xdylanm/usb-c-psu/images/AP630205_typical_app.png

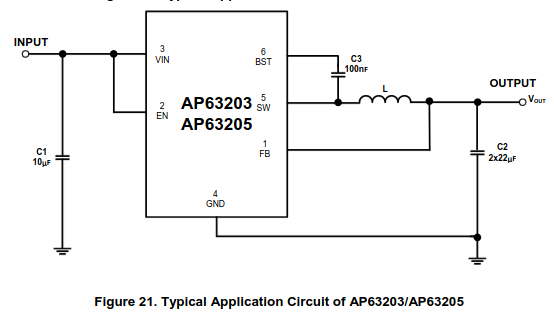
images/AP630205_typical_app.png
