xdylanm/usb-c-psu/images/block_diagram.png

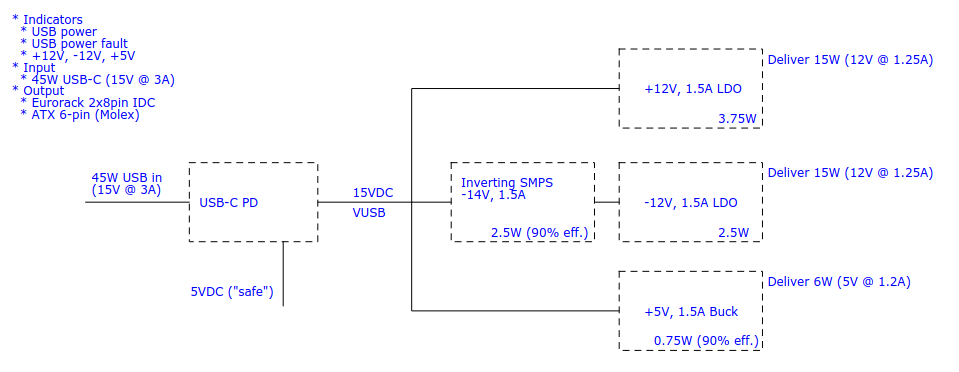
images/block_diagram.png
