xdylanm/usb-c-psu/images/current_paths_inverting_topo.png

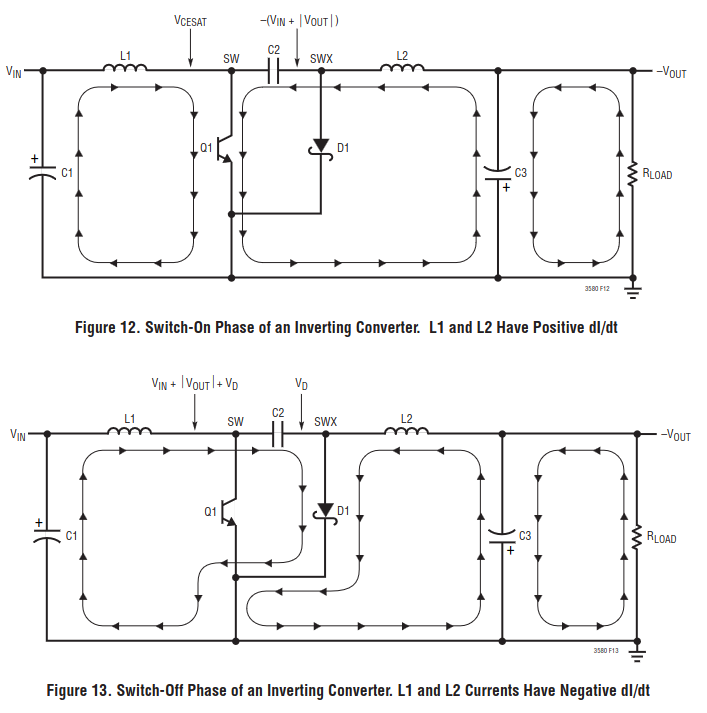
images/current_paths_inverting_topo.png
