xdylanm/usb-c-psu/images/demo_board.png

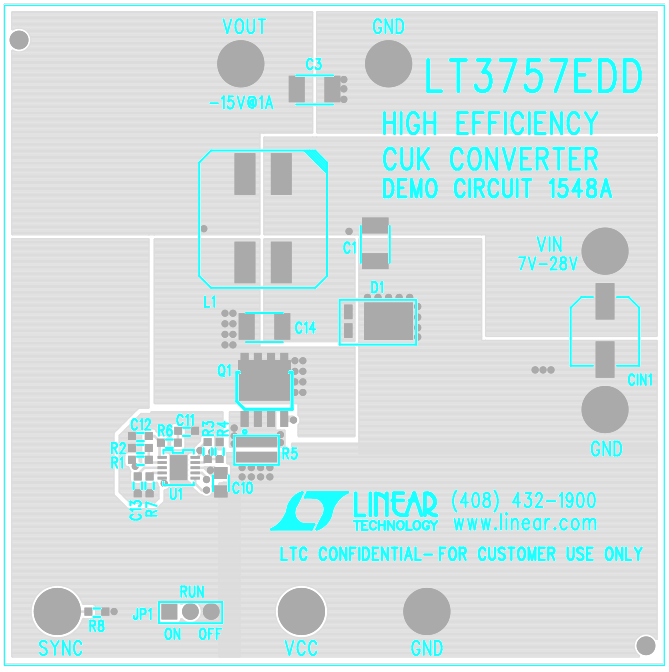
images/demo_board.png
