xdylanm/usb-c-psu/images/psu3d.png

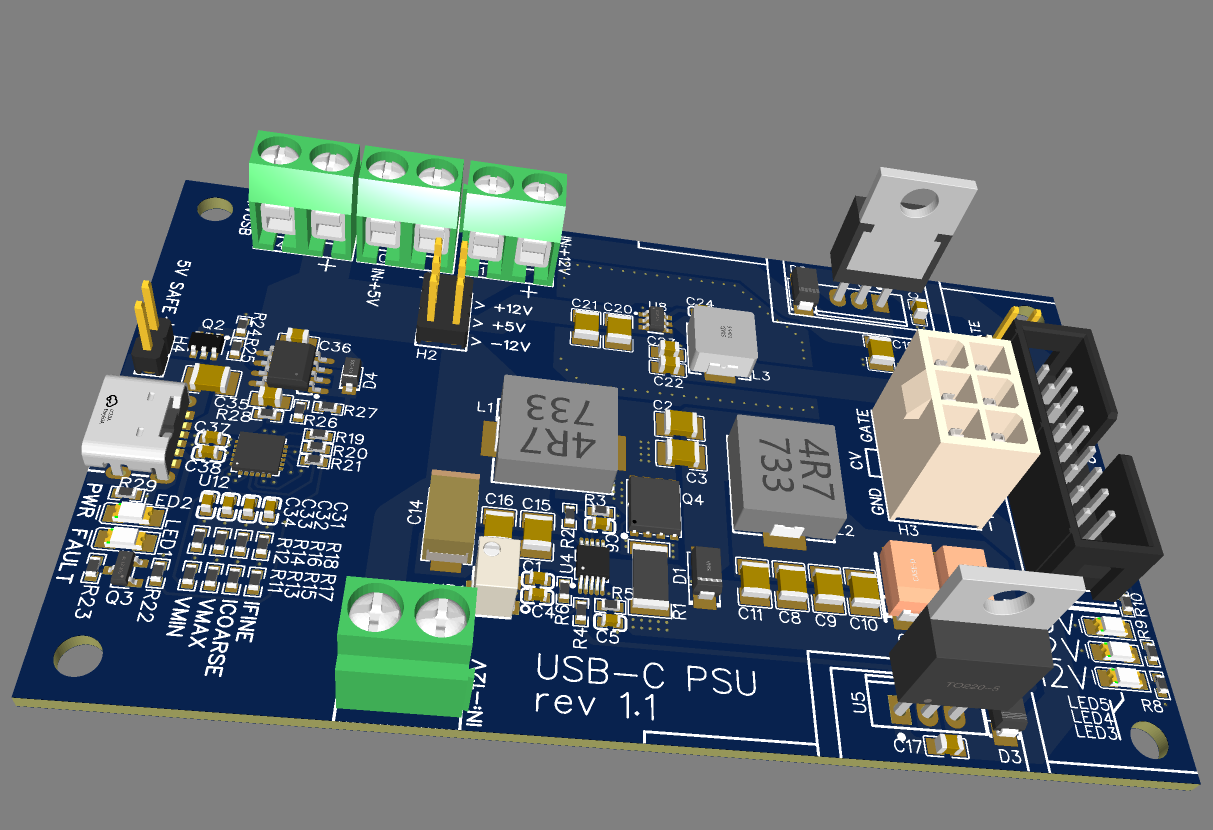
images/psu3d.png
