xdylanm/usb-c-psu/images/typical_app_inverting_converter.png

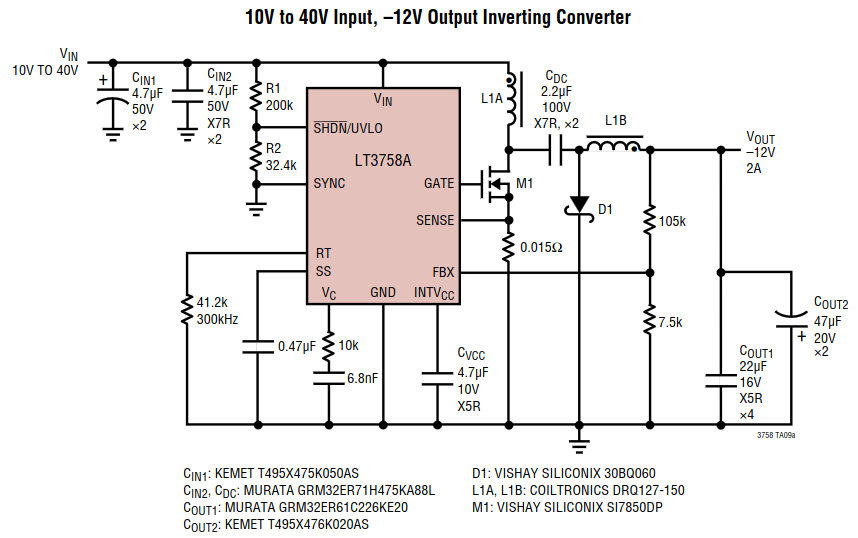
images/typical_app_inverting_converter.png
