xdylanm/usb-c-psu/images/typical_layout_inverting_mutual_L.png

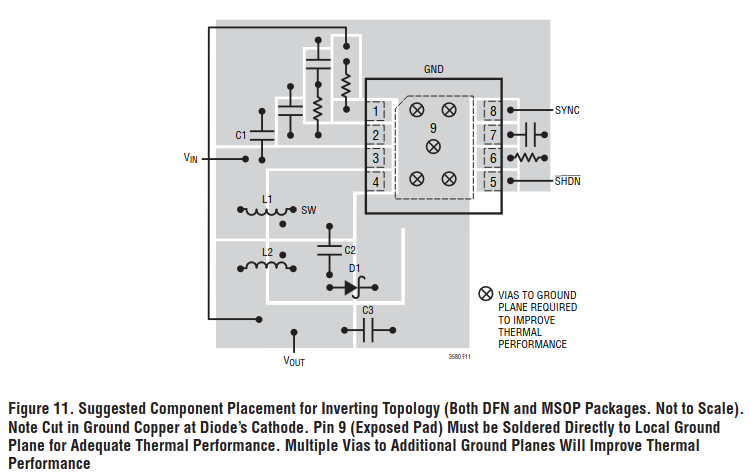
images/typical_layout_inverting_mutual_L.png
