xdylanm/usb-c-psu/design/BOM_USBC-12V-PSU_2024-03-01.csv

ID | Name | Designator | Footprint | Quantity | Manufacturer Part | Manufacturer | Supplier | Supplier Part | Price
1 | FDS4935A | Q1 | SOIC-8_L4.9-W3.9-P1.27-LS6.1-BL | 1 | FDS4935A | onsemi(安森美) | LCSC | C236903 | 0.84
2 | S1M_C232826 | D2,D3 | SMA_L4.4-W2.7-LS5.1-RD | 2 | S1M | onsemi(安森美) | LCSC | C232826 | 0.103
3 | 33uH | L1,L2 | IND-SMD_L11.5-W10.0_104CDMCCDS | 2 | 104CDMCCDS-330MC | Sumida(胜美达) | LCSC | C2454199 | 0.656
4 | U262-061N-4BVC11 | USB1 | USB-SMD_U262-061N-4BVC11 | 1 | U262-061N-4BVC11 | XKB Connectivity(中国星坤) | LCSC | C2764612 | 0.05
5 | 10uH | L3 | IND-SMD_L7.0-W6.6 | 1 | 0624CDMCCDS-100MC | Sumida(胜美达) | LCSC | C2928921 | 0.473
6 | PZ254V-11-02P | H5,H4 | HDR-TH_2P-P2.54-V-M | 2 | PZ254V-11-02P | XFCN(兴飞) | LCSC | C492401 | 0.014
7 | 4.7uF | C21,C15,C16,C20 | C1210 | 4 | GRM32ER71H475KA88L | muRata(村田) | LCSC | C86052 | 0.098
8 | SDT5A60SA-13 | D1 | SMA_L4.3-W2.6-LS5.2-RD | 1 | SDT5A60SA-13 | DIODES(美台) | LCSC | C3024223 | 0.171
9 | BZT52C10-7-F | D4 | SOD-123_L2.7-W1.6-LS3.7-RD | 1 | BZT52C10-7-F | DIODES(美台) | LCSC | C155227 | 0.02
10 | LTST-C150KGKT | LED3,LED4,LED5,LED2 | LED1206-RD | 4 | LTST-C150KGKT | LITEON(光宝) | LCSC | C125085 | 0.024
11 | NTR4503NT1G | Q3 | SOT-23-3_L2.9-W1.3-P1.90-LS2.4-BR | 1 | NTR4503NT1G | onsemi(安森美) | LCSC | C94763 | 0.199
12 | XY126V-5.0-2P | U1,U10,U11,U14 | CONN-TH_XY126V-5.0-2P | 4 | XY126V-5.0-2P | XINLAIYA(新莱亚) | LCSC | C557646 | 0.078
13 | LT3757AIMSE#PBF | U4 | MSOP-10_L3.0-W3.0-P0.50-LS5.0-BL-EP | 1 | LT3757AIMSE#PBF | ADI/LINEAR | Digi-Key | 505-LT3757AIMSE#PBF-ND
14 | L7912CV-DG | U5 | TO-220-3_L10.0-W4.5-P2.54-L | 1 | L7912CV-DG | ST(意法半导体) | LCSC | C3797 | 0.288
15 | L7812CV-DG | U7 | TO-220-3_L10.0-W4.5-P2.54-L | 1 | L7812CV-DG | ST(意法半导体) | LCSC | C2914 | 0.22
16 | AP63205WU-7 | U8 | TSOT-23-6_L2.9-W1.6-P0.95-LS2.8-BL | 1 | AP63205WU-7 | DIODES(美台) | LCSC | C2071056 | 0.489
17 | CYPD3177-24LQXQ_C2959321 | U12 | TQFN-24_L4.0-W4.0-P0.50-TL-EP2.8 | 1 | CYPD3177-24LQXQ | CYPRESS(赛普拉斯) | LCSC | C2959321 | 1.33
18 | 20kΩ | VR1 | RES-ADJ-SMD_3224W | 1 | 3224W-1-203E | BOURNS | LCSC | C55071 | 0.975
19 | 100pF | C1 | C0603 | 1 | GRM1885C1H101JA01D | muRata(村田) | LCSC | C71664 | 0.005
20 | 6.8nF | C4 | C0603 | 1 | GRM1885C1H682JA01D | muRata(村田) | LCSC | C162241 | 0.016
21 | 68nF | C5 | C0603 | 1 | GCJ188R71H683KA12D | muRata(村田) | LCSC | C354385 | 0.038
22 | 22uF | C6 | C0603 | 1 | GRM188R61A226ME15D | muRata(村田) | LCSC | C84419 | 0.017
23 | 22uF | C8,C9,C10,C11 | C1210 | 4 | GRM32ER71E226KE15L | muRata(村田) | LCSC | C21397 | 0.193
24 | 47uF | C12,C13 | CASE-D_7343 | 2 | TAJD476K025RNJ | Kyocera AVX | LCSC | C7228 | 0.636
25 | 22uF | C14 | CAP-SMD_L7.3-W4.3-RD | 1 | TAJD226K035RNJ | Kyocera AVX | LCSC | C7225 | 0.617
26 | 1uF | C17,C18,C35,C36 | C0805 | 4 | GCM21BR71H105KA03L | muRata(村田) | LCSC | C126592 | 0.05
27 | 3.3uF | C19,C39 | C1210 | 2 | GRM32DR71H335KA88L | muRata(村田) | LCSC | C397310 | 0.236
28 | 22uF | C22,C23 | C0805 | 2 | GRT21BR61C226ME13L | muRata(村田) | LCSC | C711104 | 0.141
29 | 100nF | C24,C33,C34 | C0603 | 3 | GRM188R71H104KA93D | muRata(村田) | LCSC | C77055 | 0.004
30 | 1uF | C31,C32 | C0603 | 2 | GRM188R61H105KAALD | muRata(村田) | LCSC | C77386 | 0.019
31 | 470pF | C37,C38 | C0603 | 2 | GRM1885C1H471JA01D | muRata(村田) | LCSC | C85979 | 0.008
32 | PZ254V-12-6P | H2 | HDR-TH_6P-P2.54-V-M-R2-C3-S2.54 | 1 | PZ254V-12-6P | XFCN(兴飞) | LCSC | C492420 | 0.033
33 | LTST-C150KRKT | LED1 | LED1206-RD | 1 | LTST-C150KRKT | LITEON(光宝) | LCSC | C125086 | 0.025
34 | SIR184DP-T1-RE3 | Q4 | PDFN-8_L5.8-W4.9-P1.27-LS6.1-BL | 1 | SIR184DP-T1-RE3 | VISHAY(威世) | LCSC | C727846 | 1.282
35 | 20mΩ | R1 | R2512 | 1 | PA2512FKE7W0R02E | YAGEO(国巨) | LCSC | C375689 | 0.099
36 | 180kΩ | R2 | R0603 | 1 | RC0603FR-07180KL | YAGEO(国巨) | LCSC | C123419 | 0.001
37 | 33kΩ | R3 | R0603 | 1 | RC0603FR-0733KL | YAGEO(国巨) | LCSC | C126359 | 0.001
38 | 105kΩ | R4 | R0603 | 1 | RC0603FR-07105KL | YAGEO(国巨) | LCSC | C141685 | 0.001
39 | 10.5kΩ | R5 | R0603 | 1 | RT0603DRD0710K5L | YAGEO(国巨) | LCSC | C728609 | 0.015
40 | 22kΩ | R6 | R0603 | 1 | RC0603FR-0722KL | YAGEO(国巨) | LCSC | C114065 | 0.001
41 | 1kΩ | R8,R9,R23,R24,R26 | R0603 | 5 | RC0603FR-071KL | YAGEO(国巨) | LCSC | C22548 | 0.001
42 | 330Ω | R10 | R0603 | 1 | RC0603FR-07330RL | YAGEO(国巨) | LCSC | C105881 | 0.001
43 | 5.1kΩ | R11,R12,R13,R14,R15,R16,R17 | R0603 | 7 | RC0603FR-075K1L | YAGEO(国巨) | LCSC | C105580 | 0.001
44 | 0Ω | R18 | R0603 | 1 | RC0603JR-070RL | YAGEO(国巨) | LCSC | C95177 | 0.001
45 | 2.2kΩ | R19,R20,R29 | R0603 | 3 | RC0603JR-072K2L | YAGEO(国巨) | LCSC | C113303 | 0.001
46 | 49.9kΩ | R21,R25,R27 | R0603 | 3 | RC0603FR-0749K9L | YAGEO(国巨) | LCSC | C114624 | 0.001
47 | 100kΩ | R22 | R0603 | 1 | RC0603FR-07100KL | YAGEO(国巨) | LCSC | C14675 | 0.001
48 | 10kΩ | R28 | R0603 | 1 | RC0603FR-0710KL | YAGEO(国巨) | LCSC | C98220 | 0.001
49 | 2.2uF | C2,C3 | C1210 | 2 | GRM32ER72A225KA35L | muRata(村田) | LCSC | C86054 | 0.137
50 | HDR-IDC-2.54-2X8P | H1 | IDC-TH_16P-P2.54_C3406 | 1 | 2.54-2*8P简牛 | BOOMELE(博穆精密) | LCSC | C3406 | 0.092
51 | 39288060 | H3 | CONN-TH_39288060 | 1 | 39288060 | MOLEX | LCSC | C505058 | 0.357
52 | DMP2240UDM-7 | Q2 | SOT-26_L3.0-W1.6-P0.95-LS2.8-BL | 1 | DMP2240UDM-7 | DIODES(美台) | LCSC | C397948 | 0.114
