xdylanm/usb-c-psu/design/schematic/Schematic_USBC-12V-PSU_2024-03-01.pdf

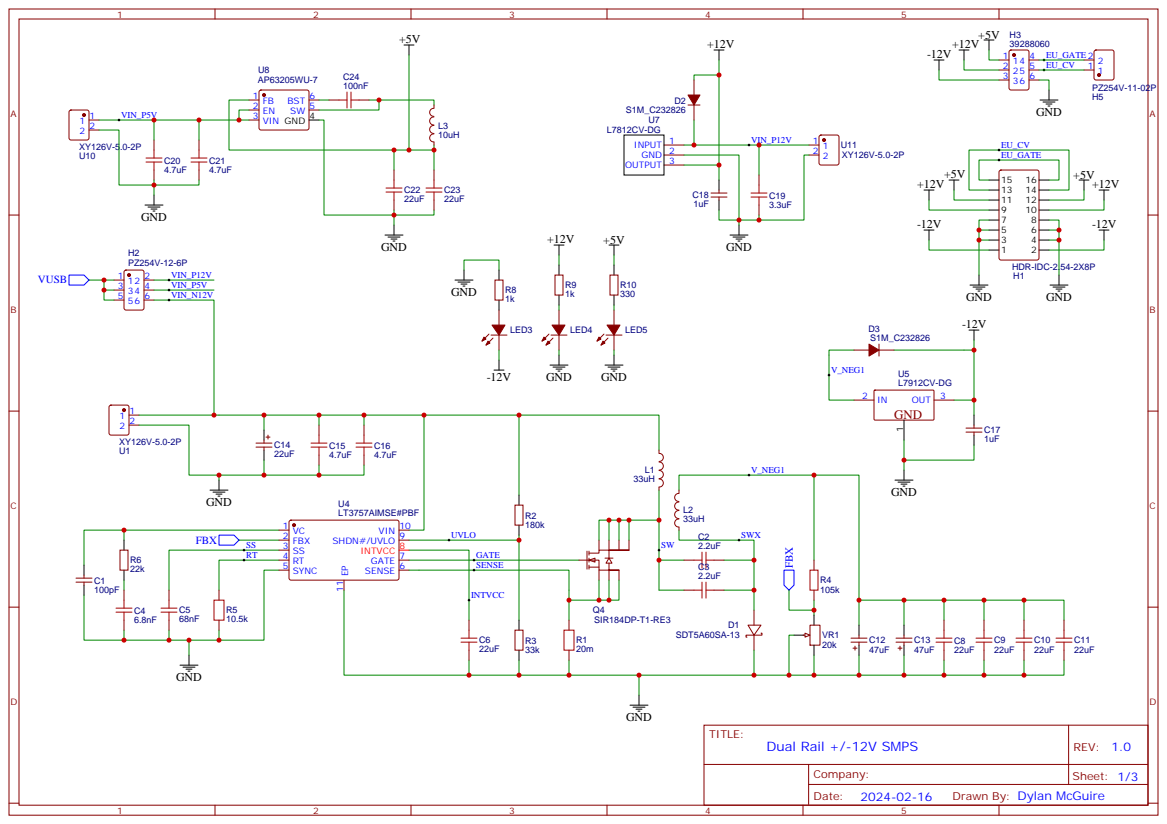
[picture p8: page 1]

Drawn By: Dylan McGuire

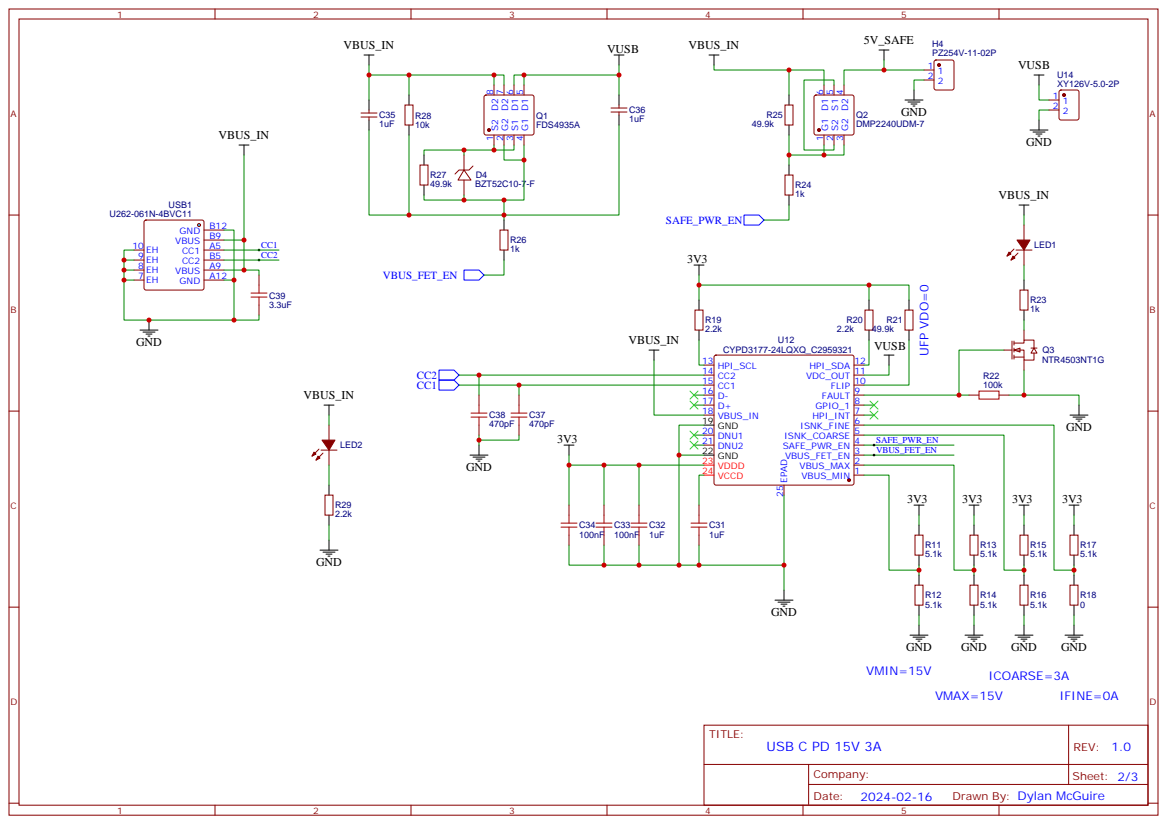
[picture p9: page 2]

A | A
B | B
C | C
D | D

TITLE:
Block Diagram | REV: 1.0

### USB-C PD

### * Indicators * USB power * USB power fault * +12V, -12V, +5V * Input * 45W USB-C (15V @ 3A) * Output * Eurorack 2x8pin IDC * ATX 6-pin (Molex)

### Inverting SMPS

15VDC | -14V, 1.5A

### 5VDC ("safe")

### -12V, 1.5A LDO

### +12V, 1.5A LDO

### +5V, 1.5A Buck

### VUSB

3.75W

2.5W (90% eff.) | 2.5W

### 0.75W (90% eff.)

### 45W USB in

(15V @ 3A)

### Deliver 15W (12V @ 1.25A)

### Deliver 15W (12V @ 1.25A)

### Deliver 6W (5V @ 1.2A)
