xdylanm/usb-c-psu/hardware/dualrailusbc/dualrailusbc.kicad_pcb

## KiCad design hardware/dualrailusbc/dualrailusbc.kicad_pcb (2024-06-20)

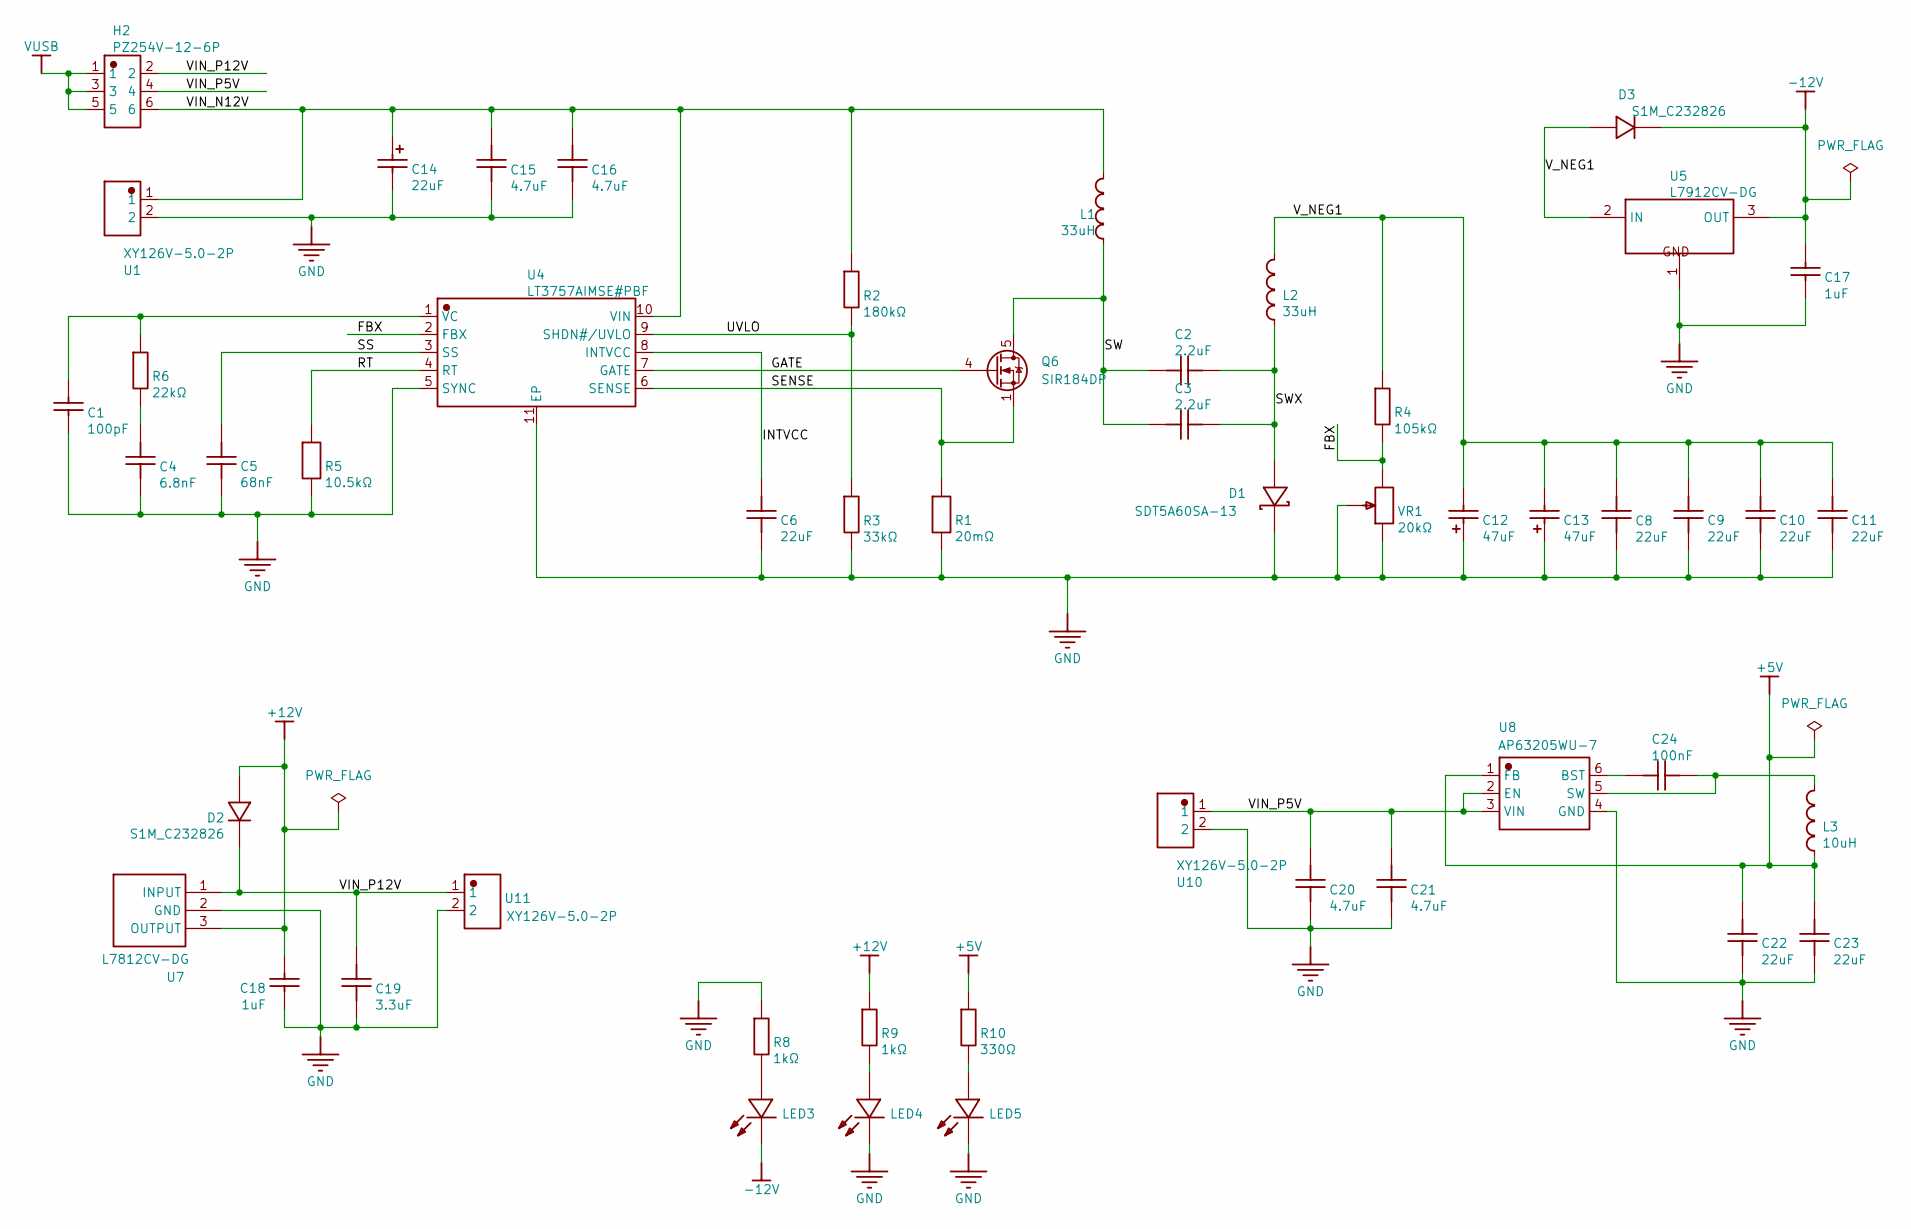
[picture p10: schematic output_rails.kicad_sch]

Parts:
C1: 100pF; C_0603_1608Metric; MANUFACTURER PART GRM1885C1H101JA01D; JLCPCB PART CLASS Extended Part
C2, C3: 2.2uF; C_1210_3225Metric; MANUFACTURER PART GRM32ER72A225KA35L; JLCPCB PART CLASS Extended Part
C4: 6.8nF; C_0603_1608Metric; MANUFACTURER PART GRM1885C1H682JA01D; JLCPCB PART CLASS Extended Part
C5: 68nF; C_0603_1608Metric; MANUFACTURER PART GCJ188R71H683KA12D; JLCPCB PART CLASS Extended Part
C6: 22uF; C_0603_1608Metric; MANUFACTURER PART GRM188R61A226ME15D; JLCPCB PART CLASS Extended Part
C8, C9, C10, C11: 22uF; C_1210_3225Metric; MANUFACTURER PART GRM32ER71E226KE15L; JLCPCB PART CLASS Extended Part
C12, C13: 47uF; CP_EIA-7343-30_AVX-N; MANUFACTURER PART TAJD476K025RNJ; JLCPCB PART CLASS Extended Part
C14: 22uF; CP_EIA-7343-30_AVX-N; MANUFACTURER PART TAJD226K035RNJ; JLCPCB PART CLASS Extended Part
C15, C16, C20, C21: 4.7uF; C_1210_3225Metric; MANUFACTURER PART GRM32ER71H475KA88L; JLCPCB PART CLASS Extended Part
C17, C18: 1uF; C_0805_2012Metric; MANUFACTURER PART GCM21BR71H105KA03L; JLCPCB PART CLASS Extended Part
C19: 3.3uF; C_1210_3225Metric; MANUFACTURER PART GRM32DR71H335KA88L; JLCPCB PART CLASS Extended Part
C22, C23: 22uF; C_0805_2012Metric; MANUFACTURER PART GRT21BR61C226ME13L; JLCPCB PART CLASS Extended Part
C24: 100nF; C_0603_1608Metric; MANUFACTURER PART GRM188R71H104KA93D; JLCPCB PART CLASS Extended Part
D1: SDT5A60SA-13; D_SMA; MANUFACTURER PART SDT5A60SA-13; JLCPCB PART CLASS Extended Part
D2, D3: S1M_C232826; D_SMA; MANUFACTURER PART S1M; JLCPCB PART CLASS Extended Part
H2: PZ254V-12-6P; PinHeader_2x03_P2.54mm_Vertical; MANUFACTURER PART PZ254V-12-6P; JLCPCB PART CLASS Extended Part
L1, L2: 33uH; L_SMD_Sumida_L11.5mm_W10.0mm; MANUFACTURER PART 104CDMCCDS-330MC; JLCPCB PART CLASS Extended Part
L3: 10uH; L_SMD_Sumida_L7.0mm_W6.6mm; MANUFACTURER PART 0624CDMCCDS-100MC
LED3, LED4, LED5: LTST-C150KGKT; LED_1206_3216Metric; MANUFACTURER PART LTST-C150KGKT; JLCPCB PART CLASS Extended Part
Q6: SIR184DP; PowerPAK_SO-8_Single
R1: 20mΩ; R_2512_6332Metric; MANUFACTURER PART PA2512FKE7W0R02E; JLCPCB PART CLASS Extended Part
R2: 180kΩ; R_0603_1608Metric; MANUFACTURER PART RC0603FR-07180KL; JLCPCB PART CLASS Extended Part
R3: 33kΩ; R_0603_1608Metric; MANUFACTURER PART RC0603FR-0733KL; JLCPCB PART CLASS Extended Part
R4: 105kΩ; R_0603_1608Metric; MANUFACTURER PART RC0603FR-07105KL; JLCPCB PART CLASS Extended Part
R5: 10.5kΩ; R_0603_1608Metric; MANUFACTURER PART RT0603DRD0710K5L; JLCPCB PART CLASS Extended Part
R6: 22kΩ; R_0603_1608Metric; MANUFACTURER PART RC0603FR-0722KL; JLCPCB PART CLASS Extended Part
R8, R9: 1kΩ; R_0603_1608Metric; MANUFACTURER PART RC0603FR-071KL; JLCPCB PART CLASS Extended Part
R10: 330Ω; R_0603_1608Metric; MANUFACTURER PART RC0603FR-07330RL; JLCPCB PART CLASS Extended Part
U1, U10, U11: XY126V-5.0-2P; TerminalBlock_Phoenix_MKDS-1,5-2_1x02_P5.00mm_Horizontal; MANUFACTURER PART XY126V-5.0-2P; JLCPCB PART CLASS Extended Part
U4: LT3757AIMSE#PBF; MSOP-10-1EP_3x3mm_P0.5mm_EP1.68x1.88mm; MANUFACTURER PART LT3757AIMSE#PBF
U5: L7912CV-DG; TO-220-3_Vertical; MANUFACTURER PART L7912CV-DG; JLCPCB PART CLASS Extended Part
U7: L7812CV-DG; TO-220-3_Vertical; MANUFACTURER PART L7812CV-DG; JLCPCB PART CLASS Extended Part
U8: AP63205WU-7; TSOT-23-6; MANUFACTURER PART AP63205WU-7; JLCPCB PART CLASS Extended Part
VR1: 20kΩ; Potentiometer_Bourns_3224W_Vertical; MANUFACTURER PART 3224W-1-203E; JLCPCB PART CLASS Extended Part

Connections:
+5V: C22.2, C23.2, L3.1, R10.2, U8.1 (FB); also elsewhere on the board
+12V: C18.2, D2.2 (A), R9.2, U7.3 (OUTPUT); also elsewhere on the board
-12V: C17.2, D3.1 (K), LED3.1 (K), U5.3 (OUT); also elsewhere on the board
/Output Rails/FBX: R4.1, U4.2 (FBX), VR1.1
/Output Rails/GATE: Q6.4 (G), U4.7 (GATE)
/Output Rails/INTVCC: C6.2, U4.8 (INTVCC)
/Output Rails/RT: R5.2, U4.4 (RT)
/Output Rails/SENSE: Q6.1 (S), Q6.2 (S), Q6.3 (S), R1.2, U4.6 (SENSE)
/Output Rails/SS: C5.2, U4.3 (SS)
/Output Rails/SW: C2.1, C3.1, L1.1, Q6.5 (D)
/Output Rails/SWX: C2.2, C3.2, D1.2, L2.1
/Output Rails/UVLO: R2.1, R3.2, U4.9 (SHDN#/UVLO)
/Output Rails/VIN_N12V: C14.1, C15.2, C16.2, H2.6, L1.2, R2.2, U1.1, U4.10 (VIN)
/Output Rails/VIN_P5V: C20.2, C21.2, H2.4, U8.2 (EN), U8.3 (VIN), U10.1
/Output Rails/VIN_P12V: C19.1, D2.1 (K), H2.2, U7.1 (INPUT), U11.1
/Output Rails/V_NEG1: C8.2, C9.2, C10.2, C11.2, C12.2, C13.2, D3.2 (A), L2.2, R4.2, U5.2 (IN)
GND: C1.1, C4.2, C5.1, C6.1, C8.1, C9.1, C10.1, C11.1, C12.1, C13.1, C14.2, C15.1, C16.1, C17.1, C18.1, C19.2, C20.1, C21.1, C22.1, C23.1, D1.1, LED4.1 (K), LED5.1 (K), R1.1, R3.1, R5.1, R8.2, U1.2, U4.5 (SYNC), U4.11 (EP), U5.1 (GND), U7.2 (GND), U8.4 (GND), U10.2, U11.2, VR1.2, VR1.3; also elsewhere on the board
unnamed: C4.1, R6.1
unnamed: LED3.2 (A), R8.1
unnamed: LED4.2 (A), R9.1
unnamed: LED5.2 (A), R10.1
unnamed: C1.2, R6.2, U4.1 (VC)
unnamed: C24.1, U8.6 (BST)
unnamed: C24.2, L3.2, U8.5 (SW)
VUSB: H2.1, H2.3, H2.5; also elsewhere on the board

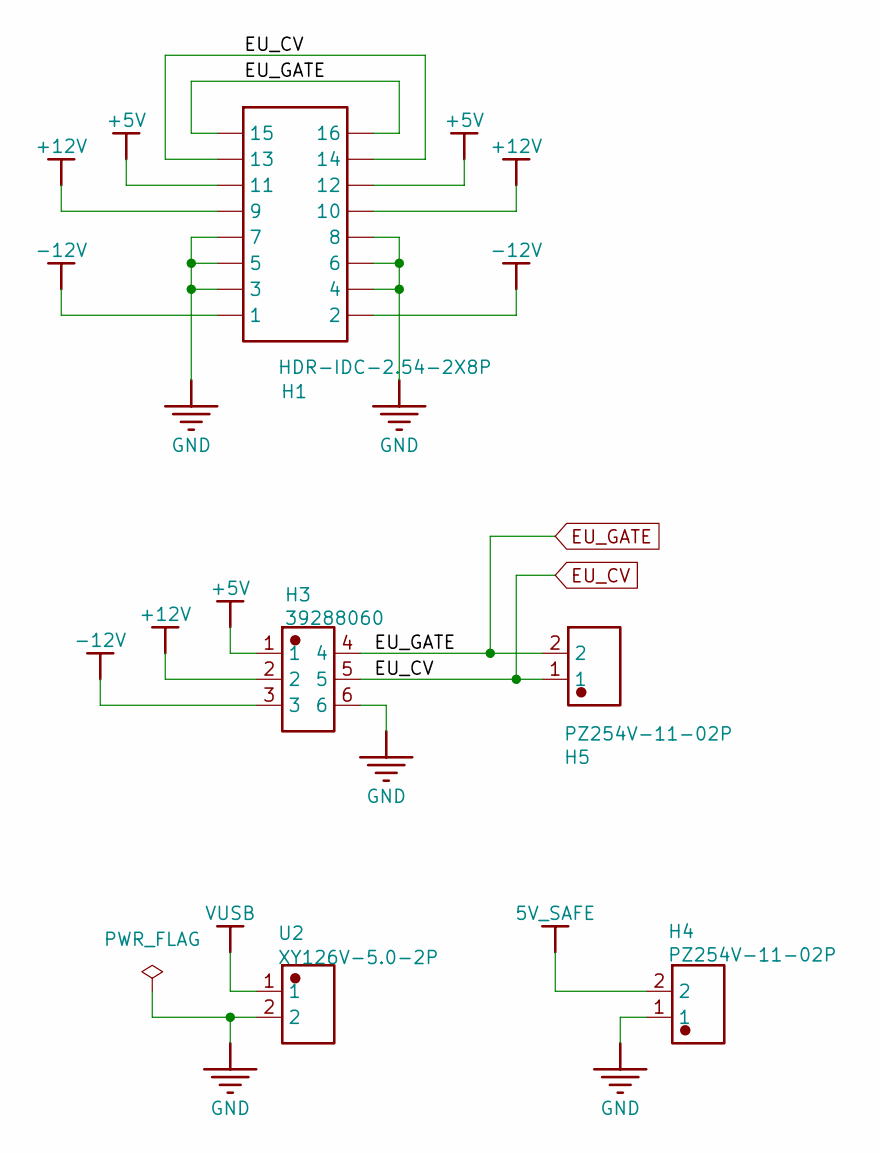
[picture p11: schematic headers.kicad_sch]

Parts:
H1: HDR-IDC-2.54-2X8P; IDC-Header_2x08_P2.54mm_Vertical; MANUFACTURER PART 2.54-2*8P简牛; JLCPCB PART CLASS Extended Part
H3: 39288060; Molex_Mini-Fit_Jr_5566-06A_2x03_P4.20mm_Vertical; MANUFACTURER PART 39288060; JLCPCB PART CLASS Extended Part
H4, H5: PZ254V-11-02P; PinHeader_2x01_P2.54mm_Vertical; MANUFACTURER PART PZ254V-11-02P; JLCPCB PART CLASS Extended Part
U2: XY126V-5.0-2P; TerminalBlock_Phoenix_MKDS-1,5-2_1x02_P5.00mm_Horizontal; MANUFACTURER PART XY126V-5.0-2P; JLCPCB PART CLASS Extended Part

Connections:
5V_SAFE: H4.2; also elsewhere on the board
+5V: H1.11, H1.12, H3.1; also elsewhere on the board
+12V: H1.9, H1.10, H3.2; also elsewhere on the board
-12V: H1.1, H1.2, H3.3; also elsewhere on the board
EU_CV: H1.13, H1.14, H3.5, H5.1
EU_GATE: H1.15, H1.16, H3.4, H5.2
GND: H1.3, H1.4, H1.5, H1.6, H1.7, H1.8, H3.6, H4.1, U2.2; also elsewhere on the board
VUSB: U2.1; also elsewhere on the board

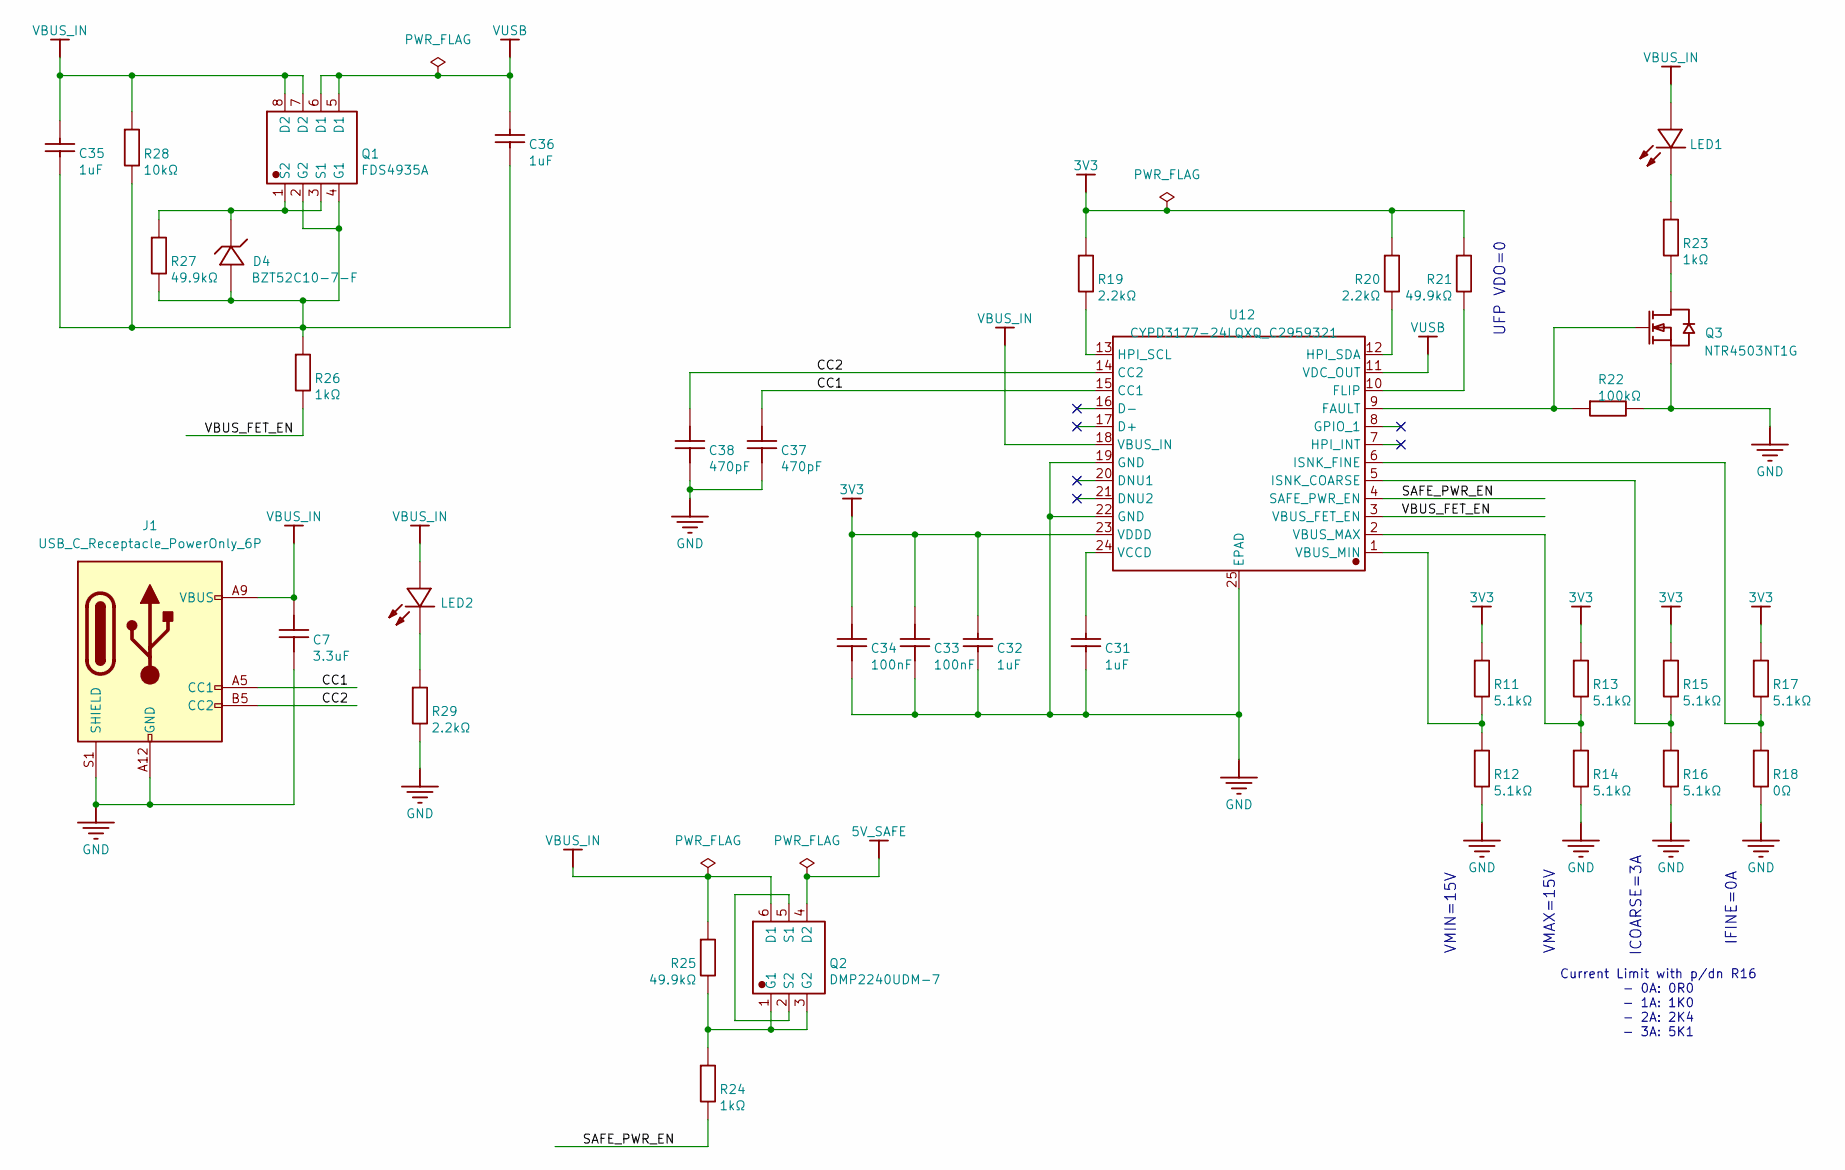
[picture p12: schematic usb-c_pd.kicad_sch]

Parts:
C7: 3.3uF; C_1210_3225Metric; MANUFACTURER PART GRM32DR71H335KA88L; JLCPCB PART CLASS Extended Part
C31, C32: 1uF; C_0603_1608Metric; MANUFACTURER PART GRM188R61H105KAALD; JLCPCB PART CLASS Extended Part
C33, C34: 100nF; C_0603_1608Metric; MANUFACTURER PART GRM188R71H104KA93D; JLCPCB PART CLASS Extended Part
C35, C36: 1uF; C_0805_2012Metric; MANUFACTURER PART GCM21BR71H105KA03L; JLCPCB PART CLASS Extended Part
C37, C38: 470pF; C_0603_1608Metric; MANUFACTURER PART GRM1885C1H471JA01D; JLCPCB PART CLASS Extended Part
D4: BZT52C10-7-F; D_SOD-123; MANUFACTURER PART BZT52C10-7-F; JLCPCB PART CLASS Extended Part
J1: USB_C_Receptacle_PowerOnly_6P; USB_C_Receptacle_GCT_USB4125-xx-x_6P_TopMnt_Horizontal
LED1: LTST-C150KRKT; LED_1206_3216Metric; MANUFACTURER PART LTST-C150KRKT; JLCPCB PART CLASS Extended Part
LED2: LTST-C150KGKT; LED_1206_3216Metric; MANUFACTURER PART LTST-C150KGKT; JLCPCB PART CLASS Extended Part
Q1: FDS4935A; SOIC-8_3.9x4.9mm_P1.27mm; MANUFACTURER PART FDS4935A
Q2: DMP2240UDM-7; SOT-23-6; MANUFACTURER PART DMP2240UDM-7; JLCPCB PART CLASS Extended Part
Q3: NTR4503NT1G; SOT-23-3; MANUFACTURER PART NTR4503NT1G; JLCPCB PART CLASS Extended Part
R11, R12, R13, R14, R15, R16, R17: 5.1kΩ; R_0603_1608Metric; MANUFACTURER PART RC0603FR-075K1L; JLCPCB PART CLASS Extended Part
R18: 0Ω; R_0603_1608Metric; MANUFACTURER PART RC0603JR-070RL; JLCPCB PART CLASS Extended Part
R19, R20, R29: 2.2kΩ; R_0603_1608Metric; MANUFACTURER PART RC0603JR-072K2L; JLCPCB PART CLASS Extended Part
R21, R25, R27: 49.9kΩ; R_0603_1608Metric; MANUFACTURER PART RC0603FR-0749K9L; JLCPCB PART CLASS Extended Part
R22: 100kΩ; R_0603_1608Metric; MANUFACTURER PART RC0603FR-07100KL; JLCPCB PART CLASS Extended Part
R23, R24, R26: 1kΩ; R_0603_1608Metric; MANUFACTURER PART RC0603FR-071KL; JLCPCB PART CLASS Extended Part
R28: 10kΩ; R_0603_1608Metric; MANUFACTURER PART RC0603FR-0710KL; JLCPCB PART CLASS Extended Part
U12: CYPD3177-24LQXQ_C2959321; TQFN-24_L4.0-W4.0-P0.50-TL-EP2.8; MANUFACTURER PART CYPD3177-24LQXQ; JLCPCB PART CLASS Extended Part

Connections:
3V3: C32.2, C33.2, C34.2, R11.2, R13.2, R15.2, R17.2, R19.2, R20.2, R21.2, U12.23 (VDDD)
5V_SAFE: Q2.4 (D2); also elsewhere on the board
/USB-C PD/CC1: C37.2, J1.A5 (CC1), U12.15 (CC1)
/USB-C PD/CC2: C38.2, J1.B5 (CC2), U12.14 (CC2)
/USB-C PD/SAFE_PWR_EN: R24.1, U12.4 (SAFE_PWR_EN)
/USB-C PD/VBUS_FET_EN: R26.1, U12.3 (VBUS_FET_EN)
GND: C7.2, C31.1, C32.1, C33.1, C34.1, C37.1, C38.1, J1.A12 (GND), J1.B12 (GND), J1.S1 (SHIELD), Q3.2 (S), R12.1, R14.1, R16.1, R18.1, R22.2, R29.1, U12.19 (GND), U12.22 (GND), U12.25 (EPAD); also elsewhere on the board
unnamed: C35.1, C36.1, D4.2 (A), Q1.2 (G2), Q1.4 (G1), R26.2, R27.1, R28.1
unnamed: D4.1 (C), Q1.1 (S2), Q1.3 (S1), R27.2
unnamed: LED1.1 (K), R23.2
unnamed: LED2.1 (K), R29.2
unnamed: Q2.1 (G1), Q2.3 (G2), R24.2, R25.1
unnamed: Q2.2 (S2), Q2.5 (S1)
unnamed: Q3.3 (D), R23.1
unnamed: Q3.1 (G), R22.1, U12.9 (FAULT)
unnamed: R21.1, U12.10 (FLIP)
unnamed: R19.1, U12.13 (HPI_SCL)
unnamed: R20.1, U12.12 (HPI_SDA)
unnamed: R15.1, R16.2, U12.5 (ISNK_COARSE)
unnamed: R17.1, R18.2, U12.6 (ISNK_FINE)
unnamed: R13.1, R14.2, U12.2 (VBUS_MAX)
unnamed: R11.1, R12.2, U12.1 (VBUS_MIN)
unnamed: C31.2, U12.24 (VCCD)
VBUS_IN: C7.1, C35.2, J1.A9 (VBUS), J1.B9 (VBUS), LED1.2 (A), LED2.2 (A), Q1.7 (D2), Q1.8 (D2), Q2.6 (D1), R25.2, R28.2, U12.18 (VBUS_IN)
VUSB: C36.2, Q1.5 (D1), Q1.6 (D1), U12.11 (VDC_OUT); also elsewhere on the board

Notes on the sheet:
ICOARSE=3A
VMAX=15V
IFINE=0A
Current Limit with p/dn R16 - 0A: 0R0 - 1A: 1K0 - 2A: 2K4 - 3A: 5K1
VMIN=15V
UFP VDO=0

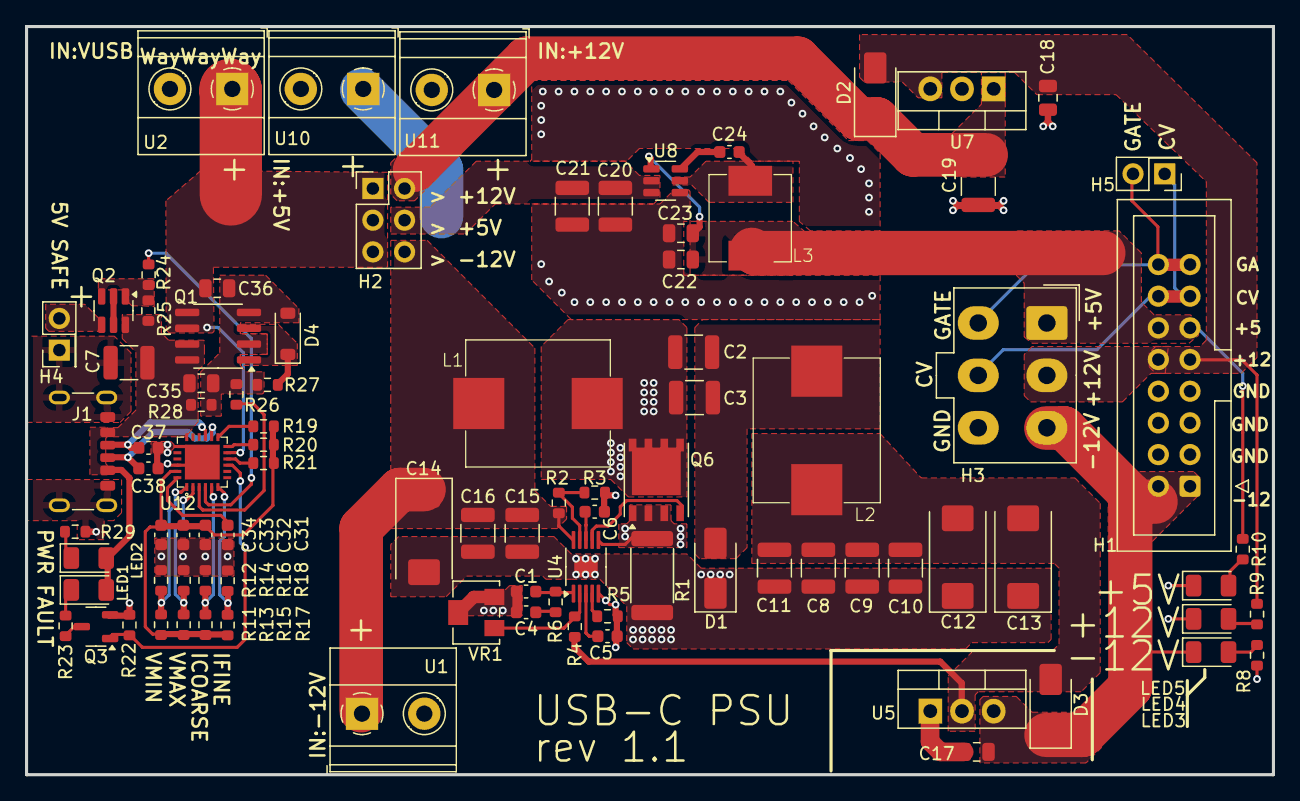
[picture p13: board dualrailusbc.kicad_pcb from above]

Board: 2 copper layers, 100.0 x 60.0 mm, 92 parts (0 on the bottom side), 50 nets.
