xdylanm/usb-c-psu/(commit log)

2024-03-02 initial design for the PSU
    [BOM_USBC-12V-PSU_2024-03-01.csv]
2024-06-20 Ported schematic and layout from EasyEDA to KiCAD. ERC & DRC OK, but had to modify some component symbols and add a few custom layouts
    [dualrailusbc.kicad_pcb, dualrailusbc.kicad_sch, headers.kicad_sch, output_rails.kicad_sch, usb-c_pd.kicad_sch]
